T-labDevelopment/ESP32-P4-NANO-Body/rev-d/ESP32_P4_NANO_RevD_assembly.step

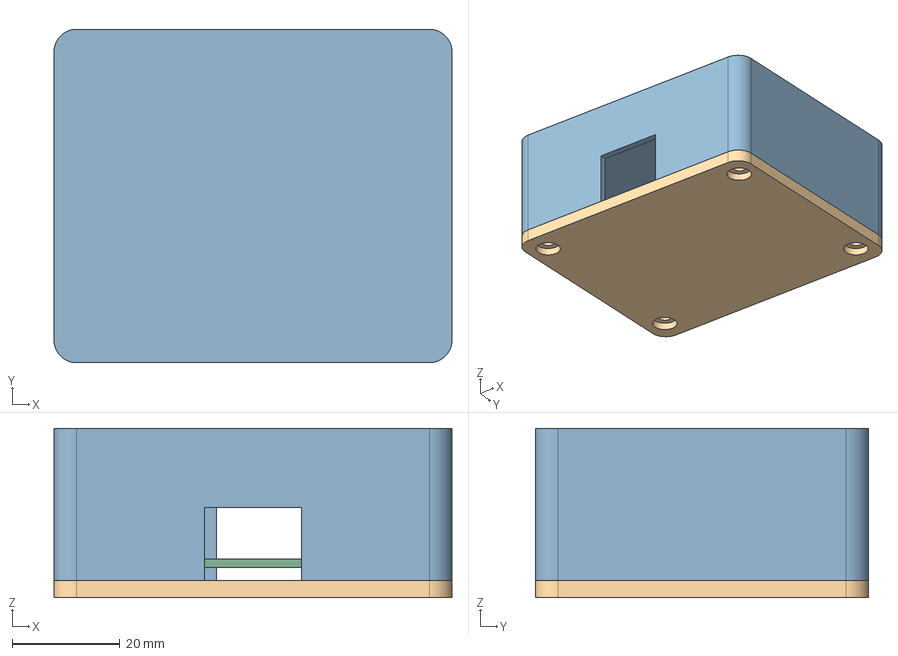
[picture p1: CAD file, 2026-10-22]
rev-d/ESP32_P4_NANO_RevD_assembly.step
74.0 x 62.0 x 31.5 mm
upper_cover
bottom_lid
PCB_outline_ESTIMATE
