T-labDevelopment/ESP32-P4-NANO-Body/rev-d/ESP32_P4_NANO_RevD_PCB_proxy.step

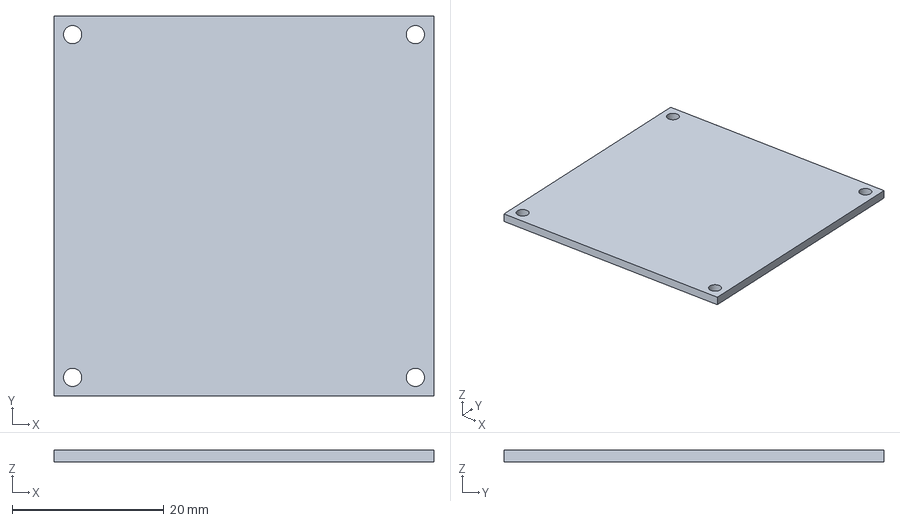
[picture p2: CAD file, 2026-10-22]
rev-d/ESP32_P4_NANO_RevD_PCB_proxy.step
50.0 x 50.0 x 1.60 mm
