T-labDevelopment/ESP32-P4-NANO-Body/rev-d/ESP32_P4_NANO_RevD_bottom.step

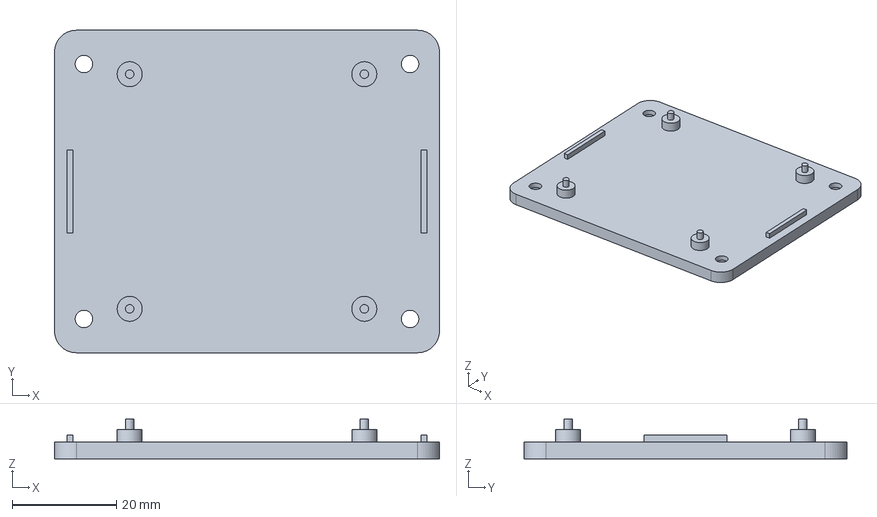
[picture p5: CAD file, 2026-10-22]
rev-d/ESP32_P4_NANO_RevD_bottom.step
74.0 x 62.0 x 7.62 mm
