T-labDevelopment/ESP32-P4-NANO-Body/rev-d/ESP32_P4_NANO_RevD_front_coupon_bottom.stl

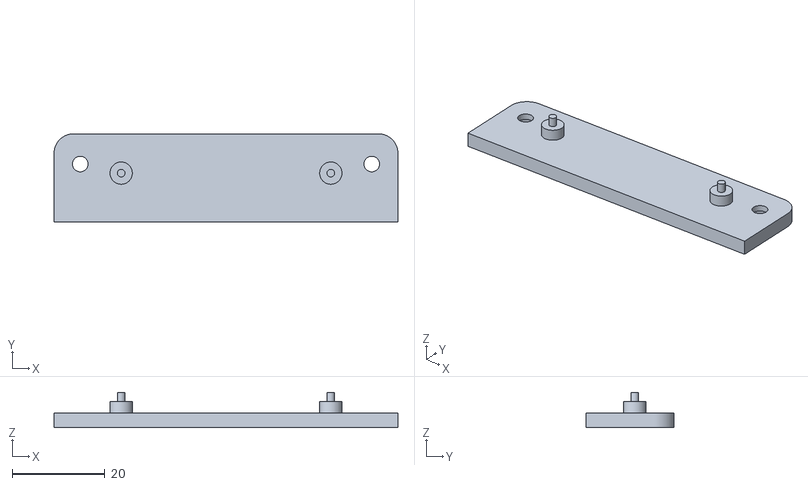
[picture p6: CAD file, 2026-10-22]
rev-d/ESP32_P4_NANO_RevD_front_coupon_bottom.stl
74.0 x 19.0 x 7.62
