T-labDevelopment/ESP32-P4-NANO-Body/rev-a/ESP32_P4_NANO_Enclosure_RevA_assembly.step

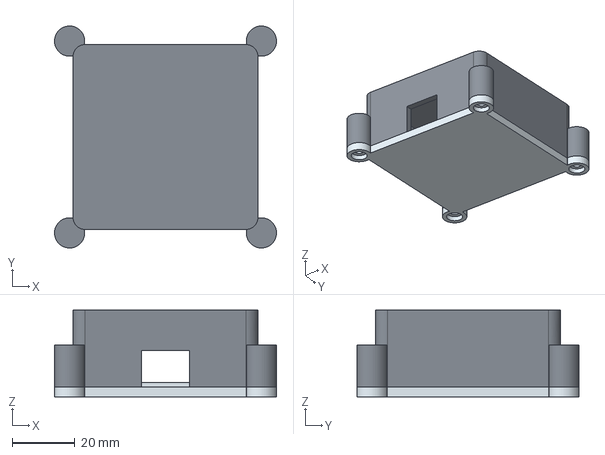
[picture p7: CAD file, 2026-10-22, an earlier design]
rev-a/ESP32_P4_NANO_Enclosure_RevA_assembly.step
70.6 x 70.6 x 27.6 mm
upper_shell
bottom_lid
