T-labDevelopment/ESP32-P4-NANO-Body/rev-c/ESP32_P4_NANO_RevC_assembly.step

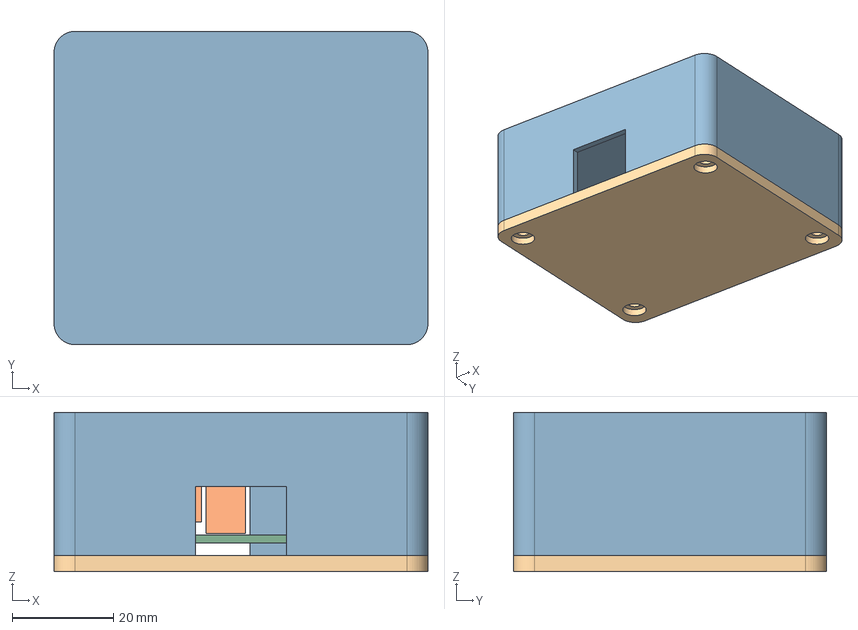
[picture p8: CAD file, 2026-10-22, an earlier design]
rev-c/ESP32_P4_NANO_RevC_assembly.step
74.0 x 62.0 x 31.5 mm
upper_cover
bottom_lid
PCB_outline_ESTIMATE
USB_A_FACE_ESTIMATE
RJ45_FACE_ESTIMATE
