T-labDevelopment/ESP32-P4-NANO-Body/rev-a/ESP32_P4_NANO_Bottom.step

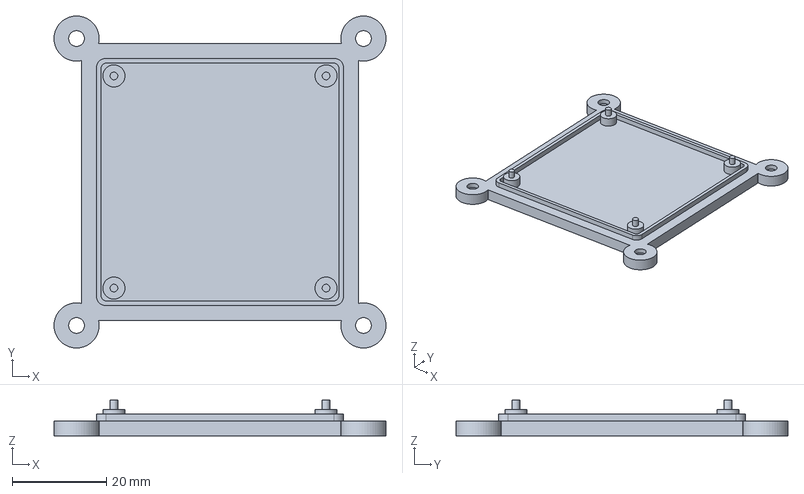
[picture p9: CAD file, 2026-10-22, an earlier design]
rev-a/ESP32_P4_NANO_Bottom.step
70.6 x 70.6 x 7.62 mm
