T-labDevelopment/ESP32-P4-NANO-Body/(list of files, cad)

Other CAD files:
rev-d/ESP32_P4_NANO_RevD_upper.step
rev-d/ESP32_P4_NANO_RevD_bottom_print.stl
rev-b/ESP32_P4_NANO_RevB_assembly.step
rev-b/ESP32_P4_NANO_RevB_bottom.step
rev-c/ESP32_P4_NANO_RevC_upper.step
rev-a/ESP32_P4_NANO_PCB_envelope_approx.step
rev-b/ESP32_P4_NANO_RevB_upper.step
rev-c/ESP32_P4_NANO_RevC_bottom.step
rev-a/ESP32_P4_NANO_Bottom_print.stl
rev-a/ESP32_P4_NANO_Upper_print.stl
rev-b/ESP32_P4_NANO_RevB_PCB_proxy.step
rev-b/ESP32_P4_NANO_RevB_upper_print.stl
rev-c/ESP32_P4_NANO_RevC_PCB_proxy.step
rev-c/ESP32_P4_NANO_RevC_front_coupon_upper.stl
rev-c/ESP32_P4_NANO_RevC_upper_print.stl
