T-labDevelopment/ESP32-P4-NANO-Body/REVISION_HISTORY.md

# ESP32-P4-NANO 筐体設計 変更履歴

- **Rev.A / 2026-10-22:** 上カバー＋底蓋、四隅外付けねじ耳、底面M3ねじ×4、基板上下挟み込み。旧ファイルは変更しない。
- **Rev.B / 2026-10-22:** 外付けねじ耳を廃止。74×62×31.5mmの角丸長方形に内蔵ねじ柱を収め、一般壁2.0mm・ポート面1.8mmに薄肉化。中空構造と基板上下4点保持を維持。開口はUSB-A+RJ45共通、USB-C独立。実基板のフィット・熱は未確認。

Rev.B CAD: [rev-b](rev-b/README.md)

- **Rev.C / 2026-10-22:** ユーザー提供の実物写真でRev.BのUSB-A/RJ45共通開口が左へ偏る失敗を確認。基板向きを固定したまま開口CAD X範囲を -21.4～+13.4mm から -23.0～+1.8mmへ変更。端子側の前面カットモデルを追加し、全体再印刷前に嵌合確認する方針。CAD干渉試験はPASS、現物嵌合は未検証。

- **Rev.D / 2026-10-23:** USB-A/RJ45共通開口の左右余白比率をRev.Cから反転し、広い壁面側へ5.0mm拡張。CAD X範囲 -6.8～+23.0mm、幅29.8mm。正面視左14.0mm／右30.2mmの外面側余白。4点固定・基板向き・USB-C側は維持し、検証用端子面カットモデルを継続。現物嵌合未検証。
