T-labDevelopment/ESP32-P4-NANO-Body/(commit log)

2026-10-22 Initialize dedicated ESP32-P4-NANO enclosure repository
2026-10-22 Import rev-a/generate_enclosure.py from WebTRX-Lanadapter enclosure CAD
2026-10-22 Import rev-a/render_preview.py from WebTRX-Lanadapter enclosure CAD
2026-10-22 Import rev-a/requirements.txt from WebTRX-Lanadapter enclosure CAD
2026-10-22 Import rev-b/generate_enclosure.py from WebTRX-Lanadapter enclosure CAD
2026-10-22 Import rev-b/render_preview.py from WebTRX-Lanadapter enclosure CAD
2026-10-22 Import rev-b/requirements.txt from WebTRX-Lanadapter enclosure CAD
2026-10-22 Import rev-b/README.md from WebTRX-Lanadapter enclosure CAD
2026-10-22 Import REVISION_HISTORY.md from WebTRX-Lanadapter enclosure CAD
2026-10-22 docs: complete independent enclosure repository (rev-a/README.md)
2026-10-22 docs: complete independent enclosure repository (.gitignore)
2026-10-22 ci: generate and commit STL STEP from versioned CadQuery sources
2026-10-22 build(cad): regenerate STL and STEP for Rev.A and Rev.B [skip ci]
    [ESP32_P4_NANO_Bottom.step, ESP32_P4_NANO_Bottom_print.stl, ESP32_P4_NANO_Enclosure_RevA_assembly.step, ESP32_P4_NANO_PCB_envelope_approx.step, ESP32_P4_NANO_RevB_PCB_proxy.step, ESP32_P4_NANO_RevB_assembly.step, ESP32_P4_NANO_RevB_bottom.step, ESP32_P4_NANO_RevB_bottom_print.stl]
2026-10-22 fix(cad): align USB-A and RJ45 opening with physical PCB orientation (Rev.C)
2026-10-22 docs: record Rev.C field failure and staged port-fit test
2026-10-22 ci: add Rev.C corrected model and port-fit coupon STL/STEP generation
2026-10-22 build(cad): regenerate STL and STEP for Rev.A/Rev.B/Rev.C [skip ci]
    [ESP32_P4_NANO_Bottom.step, ESP32_P4_NANO_Enclosure_RevA_assembly.step, ESP32_P4_NANO_PCB_envelope_approx.step, ESP32_P4_NANO_RevB_PCB_proxy.step, ESP32_P4_NANO_RevB_assembly.step, ESP32_P4_NANO_RevB_bottom.step, ESP32_P4_NANO_RevB_upper.step, ESP32_P4_NANO_RevC_PCB_proxy.step]
2026-10-22 fix: create Rev.D mirrored USB-A/RJ45 opening, expand 5mm into wider wall
    Preserve older revisions and untouched mechanical features; add front-fit coupons and pinned CadQuery CI generation.
2026-10-22 build(cad): regenerate STL and STEP for Rev.A/Rev.B/Rev.C/Rev.D [skip ci]
    [ESP32_P4_NANO_Bottom.step, ESP32_P4_NANO_Enclosure_RevA_assembly.step, ESP32_P4_NANO_PCB_envelope_approx.step, ESP32_P4_NANO_RevB_PCB_proxy.step, ESP32_P4_NANO_RevB_assembly.step, ESP32_P4_NANO_RevB_bottom.step, ESP32_P4_NANO_RevB_upper.step, ESP32_P4_NANO_RevC_PCB_proxy.step]
